TheRealGecko/BLDC-Motor-Controller/hardware/schematic/BLDC_Controller_Rev1.pdf

M

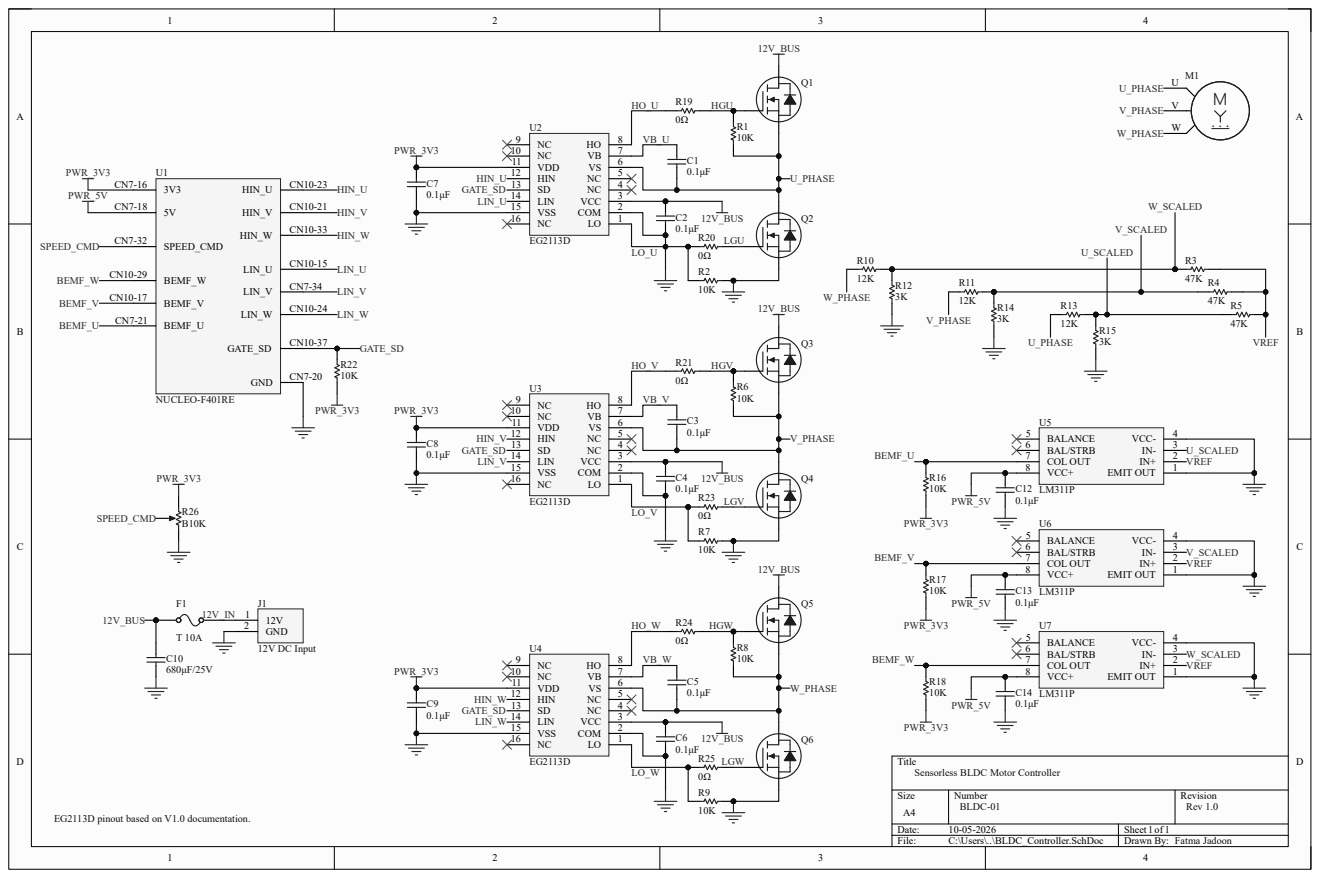
[picture p2: page 1]

Title
Sensorless BLDC Motor Controller

EG2113D pinout based on V1.0 documentation.
