TheRealGecko/BLDC-Motor-Controller/firmware/stm32/bldc_controller/bldc_controller.ioc

Mcu.UserName=STM32F401RETx
PA10.GPIO_Label=HIN_C
PA10.Signal=S_TIM1_CH3
PA13.Signal=SYS_JTMS-SWDIO
PA14.Signal=SYS_JTCK-SWCLK
PA3.GPIO_Label=GATE_SD
PA3.Signal=GPIO_Output
PA4.GPIO_Label=SPEED_CMD
PA4.Signal=ADCx_IN4
PA7.GPIO_Label=LIN_A
PA7.Signal=GPIO_Output
PA8.GPIO_Label=HIN_A
PA8.Signal=S_TIM1_CH1
PA9.GPIO_Label=HIN_B
PA9.Signal=S_TIM1_CH2
PB0.GPIO_Label=LIN_B
PB0.Signal=GPIO_Output
PB1.GPIO_Label=LIN_C
PB1.Signal=GPIO_Output
PB5.GPIO_Label=BEMF_A
PB5.Signal=GPXTI5
PB6.GPIO_Label=BEMF_B
PB6.Signal=GPXTI6
PB7.GPIO_Label=BEMF_C
PB7.Signal=GPXTI7
