TheRealGecko/BLDC-Motor-Controller/firmware/stm32/BLDC Controller/Core/Inc/main.h

#define GATE_SD_Pin GPIO_PIN_3
#define GATE_SD_GPIO_Port GPIOA
#define SPEED_CMD_Pin GPIO_PIN_4
#define SPEED_CMD_GPIO_Port GPIOA
#define LIN_A_Pin GPIO_PIN_7
#define LIN_A_GPIO_Port GPIOA
#define LIN_B_Pin GPIO_PIN_0
#define LIN_B_GPIO_Port GPIOB
#define LIN_C_Pin GPIO_PIN_1
#define LIN_C_GPIO_Port GPIOB
#define HIN_A_Pin GPIO_PIN_8
#define HIN_A_GPIO_Port GPIOA
#define HIN_B_Pin GPIO_PIN_9
#define HIN_B_GPIO_Port GPIOA
#define HIN_C_Pin GPIO_PIN_10
#define HIN_C_GPIO_Port GPIOA
#define BEMF_A_Pin GPIO_PIN_5
#define BEMF_A_GPIO_Port GPIOB
#define BEMF_A_EXTI_IRQn EXTI9_5_IRQn
#define BEMF_B_Pin GPIO_PIN_6
#define BEMF_B_GPIO_Port GPIOB
#define BEMF_B_EXTI_IRQn EXTI9_5_IRQn
#define BEMF_C_Pin GPIO_PIN_7
#define BEMF_C_GPIO_Port GPIOB
#define BEMF_C_EXTI_IRQn EXTI9_5_IRQn
