TheRealGecko/BLDC-Motor-Controller/(commit log)

2026-10-06 Upload schematic
2026-10-06 Added schematic image
